HaSGO/bromoTimer/README.md

bromoTimer
==========

A timer circuit for a bromograph
