HaSGO/bromoTimer/Schematics/BromoTimer.brd

## EAGLE design Schematics/BromoTimer.brd (2014-05-28)

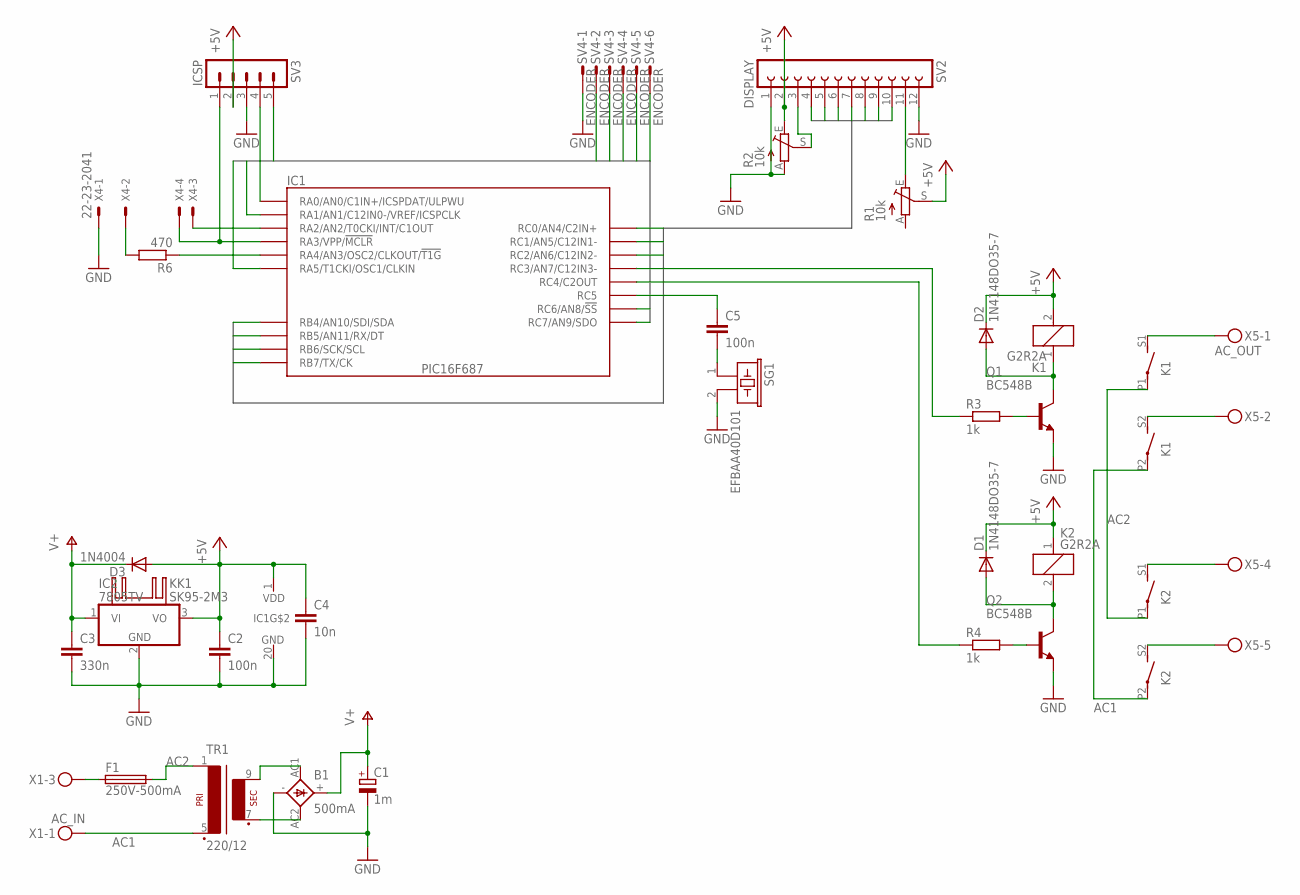
[picture p1: schematic BromoTimer.sch]

Parts:
B1: 500mA; 2KBB-R
C1: 1m; E5-13
C2: 100n; C025-024X044
C3: 330n; C050-050X075
C4: 10n; C025-024X044
C5: 100n; C075-032X103
D1, D2: 1N4148DO35-7; DO35-7
D3: 1N4004; DO41-10
F1: 250V-500mA; SH22
IC1: PIC16F687; DIP20
IC2: 7805TV; TO220V
K1, K2: G2R2A; MPN G2R-2A-DC24
KK1: SK95-2M3
Q1, Q2: BC548B; TO92-EBC
R1, R2: 10k; CA6V
R3, R4: 1k; 0207/7
R6: 470; 0207/7
SG1: EFBAA40D101
SV2: DISPLAY; FE12
SV3: ICSP; MA05-1
SV4: ENCODER; L06P
TR1: 220/12; EI30-1
X1: AC_IN; MKDSN1,5/3-5,08
X4: 22-23-2041
X5: AC_OUT; MKDSN1,5/5-5,08

Connections:
+5V: C2.1, C4.1, D1.C, D2.C, D3.A, IC1.1 (VDD), IC2.3 (VO), K1.2, K2.1, R1.S, R2.E, SV2.2, SV3.2
A: IC1.19 (RA0/AN0/C1IN+/ICSPDAT/ULPWU), SV3.4, SV4.5
AC1: K1.P2, K2.P2, TR1.5 (P2), X1.1
AC2: F1.2, K1.P1, K2.P1, TR1.1
B: IC1.18 (RA1/AN1/C12IN0-/VREF/ICSPCLK), SV3.5, SV4.6
B0: IC1.13 (RB4/AN10/SDI/SDA), SV2.7
B1: IC1.12 (RB5/AN11/RX/DT), SV2.8
B2: IC1.11 (RB6/SCK/SCL), SV2.9
B3: IC1.10 (RB7/TX/CK), SV2.10
EN: IC1.16 (RC0/AN4/C2IN+), SV2.6
GND: B1.-, C1.-, C2.2, C3.2, C4.2, IC1.20 (GND), IC2.2 (GND), Q1.E, Q2.E, R2.A, SG1.2, SV2.1, SV2.12, SV3.3, SV4.1, X4.1
LG: IC1.9 (RC7/AN9/SDO), SV4.2
LR: IC1.8 (RC6/AN8/!SS), SV4.3
unnamed: R1.E, SV2.11
unnamed: B1.AC2, TR1.7 (S3)
unnamed: R2.S, SV2.3
unnamed: Q2.B, R4.2
unnamed: Q1.B, R3.2
unnamed: D1.A, K2.2, Q2.C
unnamed: D2.A, K1.1, Q1.C
unnamed: K1.S1 (S), X5.1
unnamed: K1.S2 (S), X5.2
unnamed: K2.S1 (S), X5.4
unnamed: K2.S2 (S), X5.5
unnamed: B1.AC1, TR1.9 (S4)
unnamed: IC1.17 (RA2/AN2/T0CKI/INT/C1OUT), X4.3
unnamed: IC1.6 (RC4/C2OUT), R4.1
unnamed: IC1.4 (RA3/VPP/!MCLR), SV3.1, X4.4
unnamed: IC1.7 (RC3/AN7/C12IN3-), R3.1
unnamed: C5.1, IC1.5 (RC5)
unnamed: C5.2, SG1.1
unnamed: IC1.3 (RA4/AN3/OSC2/CLKOUT/!T1G), R6.1
unnamed: R6.2, X4.2
unnamed: F1.1, X1.3
RS: IC1.15 (RC1/AN5/C12IN1-), SV2.4
RW: IC1.14 (RC2/AN6/C12IN2-), SV2.5
SW: IC1.2 (RA5/T1CKI/OSC1/CLKIN), SV4.4
V+: B1.+, C1.+, C3.1, D3.C, IC2.1 (VI)

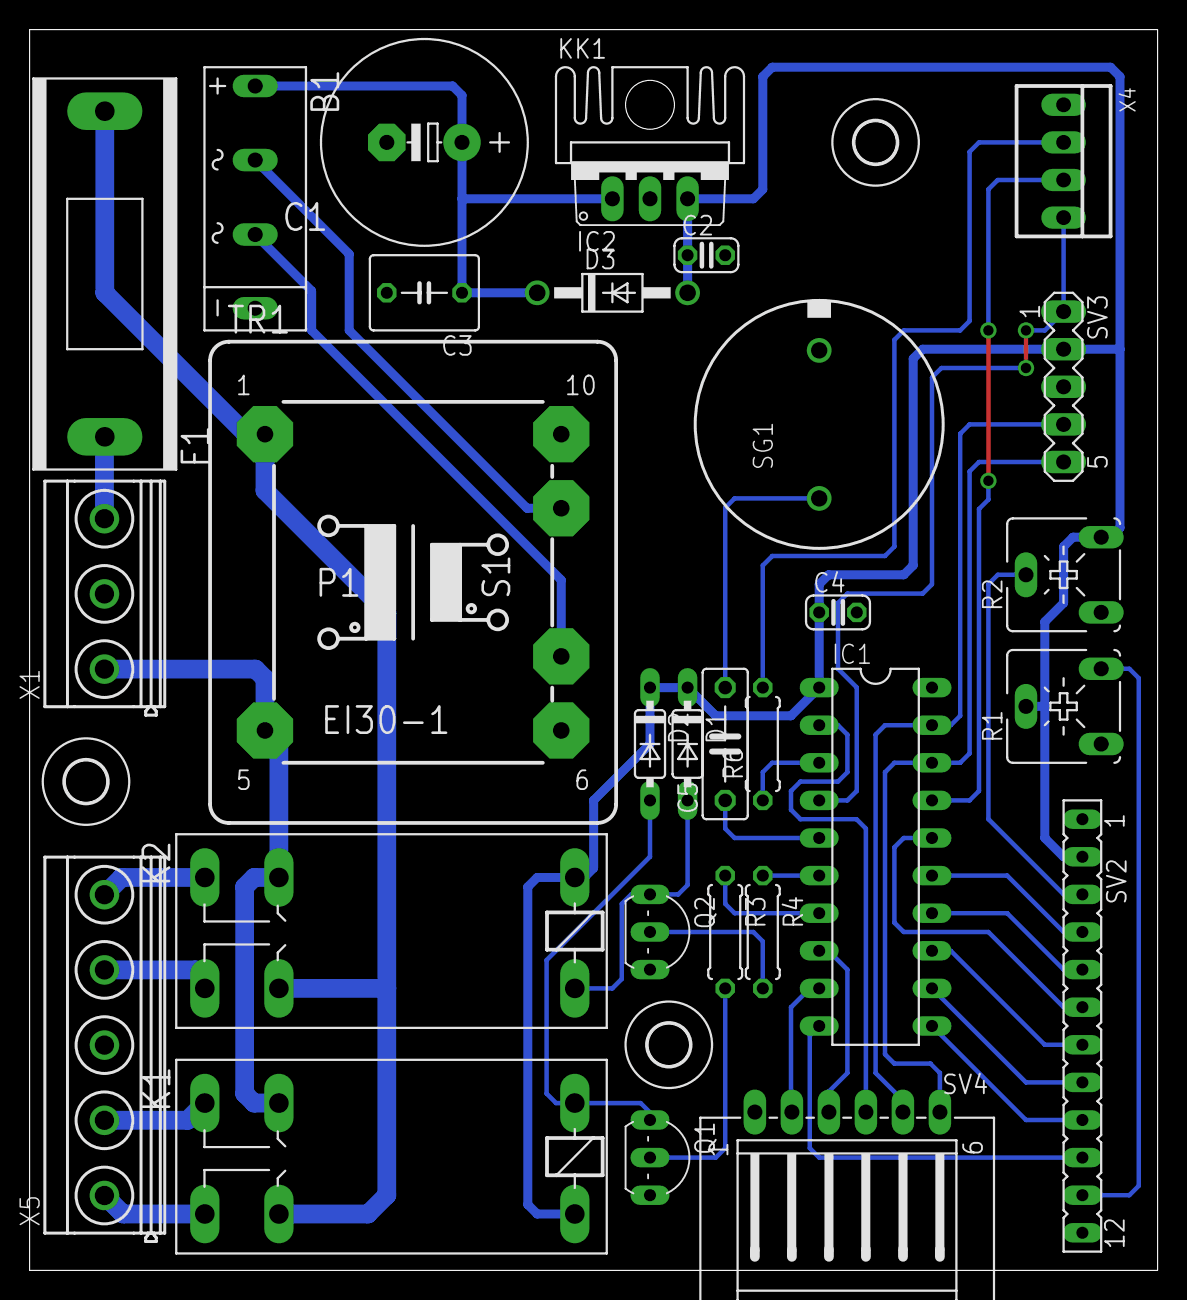
[picture p2: board BromoTimer.brd from above]

Board: 2 copper layers, 76.2 x 83.8 mm, 33 parts (0 on the bottom side), 38 nets.

Other parts of the board:
U$2, U$3, U$4: 2,8
