HaSGO/bromoTimer/Schematics/encoder.brd

## EAGLE design Schematics/encoder.brd (2013-06-17)

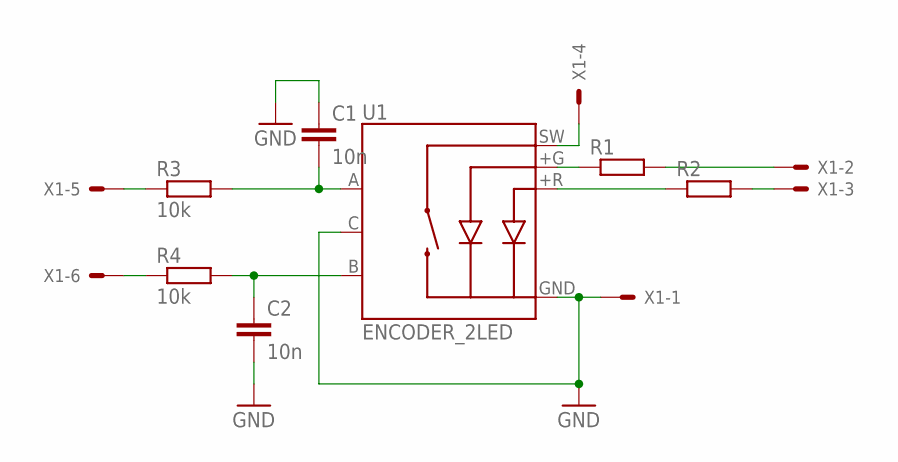
[picture p3: schematic encoder.sch]

Parts:
C1, C2: 10n; C025-024X044
R1, R2: R-EU_R0603; R0603
R3, R4: 10k; R0603
U1: ENCODER_2LED; ENCODER_LED_2
X1: 22-23-2061

Connections:
GND: C1.1, C2.2, U1.C, U1.GND (-), X1.1
unnamed: R1.2, X1.2
unnamed: R2.2, X1.3
unnamed: R1.1, U1.+G
unnamed: U1.SW, X1.4
unnamed: C1.2, R3.2, U1.A
unnamed: C2.1, R4.2, U1.B
unnamed: R2.1, U1.+R
unnamed: R4.1, X1.6
unnamed: R3.1, X1.5

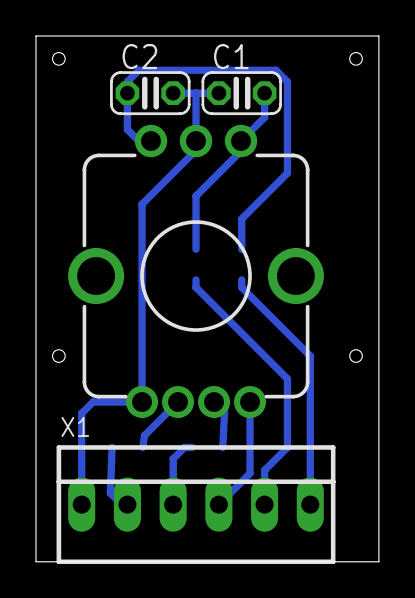
[picture p4: board encoder.brd from above]

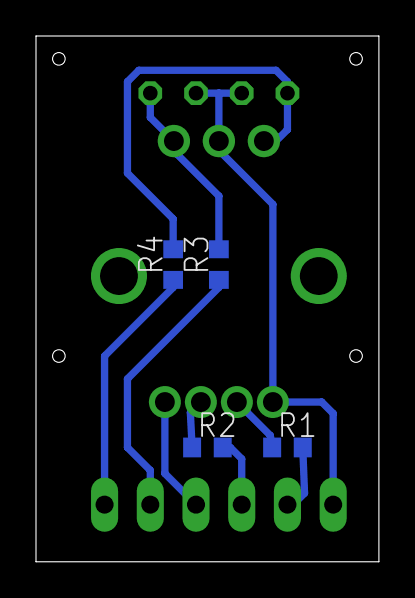
[picture p5: board encoder.brd from below]

Board: 2 copper layers, 19.1 x 29.2 mm, 8 parts (4 on the bottom side), 10 nets.
