HaSGO/bromoTimer/bromoTimer.X/main.c

/******************************************************************************/
/* Files to Include                                                           */
/******************************************************************************/

#include <xc.h>           /* Global Header File */
#include <stdint.h>        /* For uint8_t definition */
#include <stdbool.h>       /* For true/false definition */
#include <conio.h>
#include <stdio.h>

#include "system.h"        /* System funct/params, like osc/peripheral config */
#include "user.h"          /* User funct/params, such as InitApp */
#include "lcd.h"

/******************************************************************************/
/* User Global Variable Declaration                                           */
/******************************************************************************/

/* Current encoder value set by user */
uint16_t seconds = 1;

/******************************************************************************/
/* Main Program                                                               */

/******************************************************************************/

/* This function reads system flags and acts upon them. */
void inline ProcessFlags() {
    if (system_flags & ENCODER_BUTTON_PRESSED) {
        system_flags &= ~ENCODER_BUTTON_PRESSED; /* Reset encoder flag */
        if (status == mode_NOP) {
            printf("\rTurn knob to set");
            status = mode_SET;
        } else if (status == mode_SET) {
            //Start countdown
            start_countdown(seconds);
        }

    }
    if (system_flags & LID_OPEN) {
        system_flags &= ~LID_OPEN; /* Reset lid open flag */
        // User has opened lid. Check if we are counting down.
        if (status == mode_COUNTDOWN) {
            TMR1ON = 0; //Stop timer
            printf("\rLid open");
        }
    }
    if (system_flags & TIMER1_OVERFLOW) {
        system_flags &= ~TIMER1_OVERFLOW;
        /* Reset timer value */
        TMR1H = 0b10000101;
        TMR1L = 0b11101110;
        /* decrement second counter */
        if (!--seconds) { /* If we are decrementing to 0, we are done */
            LAMP_1 = 0;
            LAMP_2 = 0;
            TMR1ON = 0;
            EXT_LED = 0;
            status = mode_NOP;

            printf("\rDone!");
            PlayBuzzerMs(100);
            __delay_ms(100);
            PlayBuzzerMs(100);
        } else {
            lcd_gotoxy(2, 3); /* Go to a space after the word "remaining" */
            printf("%us", seconds);
        }
    }
}

uint8_t main(void) {
    /* Configure the oscillator for the device */
    ConfigureOscillator();

    /* Initialize I/O and Peripherals for application */
    InitApp();

    if (EXT_SW == 0) {
        printf("\rSelf test...");
        __delay_ms(200);
        SelfTest();
        printf("\r...end");
        __delay_ms(200);
        while (EXT_SW == 0) NOP();
    }

    EXT_LED = 1;

    printf("\rHaSGO Bromograph");

    static const int8_t enc_states[] = {0, -1, 1, 0, 1, 0, 0, -1, -1, 0, 0, 1, 0, 1, -1, 0};
    static uint8_t old_AB = 0;

    while (1) {
        ProcessFlags();

        switch (status) {
            case mode_SET:
                old_AB <<= 2; //remember previous state
                old_AB |= (PORTA & 0x03); //add current state
                if (enc_states[(old_AB & 0x0f)]) {
                    seconds += enc_states[(old_AB & 0x0f)];
                    lcd_clear();
                    printf("\rTimer: %us", seconds);
                }
                break;
            case mode_NOP:
                NOP();
                break;
        }
    }

    return 0;
}
