HaSGO/bromoTimer/bromoTimer.X/configuration_bits.c

/******************************************************************************/
/* Main Files to Include                                                      */
/******************************************************************************/

#include <xc.h>            /* HiTech General Includes */

/******************************************************************************/
/* Configuration Bits                                                         */
/*                                                                            */
/* Refer to your Hi-Tech User Manual in the PICC installation directory       */
/* /doc folder for more information on filling in configuration bits.         */
/* In addition, configuration bit mnemonics can be found in your              */
/* PICC\version\include\<processor name>.h file for your device.  For         */
/* additional information about what the hardware configurations mean in      */
/* terms of device operation, refer to the device datasheet.                  */
/*                                                                            */
/******************************************************************************/

// CONFIG
#pragma config FOSC = INTRCIO   // Oscillator Selection bits (INTOSCIO oscillator: I/O function on RA4/OSC2/CLKOUT pin, I/O function on RA5/OSC1/CLKIN)
#pragma config WDTE = OFF       // Watchdog Timer Enable bit (WDT disabled and can be enabled by SWDTEN bit of the WDTCON register)
#pragma config PWRTE = ON       // Power-up Timer Enable bit (PWRT enabled)
#pragma config MCLRE = OFF      // MCLR Pin Function Select bit (MCLR pin function is MCLR)
#pragma config CP = OFF         // Code Protection bit (Program memory code protection is disabled)
#pragma config CPD = OFF        // Data Code Protection bit (Data memory code protection is disabled)
#pragma config BOREN = OFF      // Brown-out Reset Selection bits (BOR disabled)
#pragma config IESO = OFF       // Internal External Switchover bit (Internal External Switchover mode is disabled)
#pragma config FCMEN = OFF      // Fail-Safe Clock Monitor Enabled bit (Fail-Safe Clock Monitor is disabled)
