HaSGO/bromoTimer/bromoTimer.X/user.h

/******************************************************************************/
/* User Level #define Macros                                                  */
/******************************************************************************/

/******************************************************************************/
/* User Function Prototypes                                                   */
/******************************************************************************/

void InitApp(void);         /* I/O and Peripheral Initialization */

inline void SelfTest();
