HaSGO/bromoTimer/(commit log)

2012-12-02 Initial commit
    Schematic is nearly done; still have to check dimensions and lay out the board.
    [BromoTimer.sch]
2012-12-02 Ignore EAGLE board backups
2012-12-02 Finished first version of the schematic.
    [BromoTimer.sch]
2012-12-02 Add board, initial component placement
    Still have to confirm component size & footprint.
    [BromoTimer.brd]
2012-12-08 Fixed bug in schematics
    The poles on the diode bridge were inverted.
    [BromoTimer.brd, BromoTimer.sch]
2012-12-08 Use 12V relay.
    Use 12V relay since V relays are not common.
    [BromoTimer.brd, BromoTimer.sch]
2012-12-08 Add ICSP header
    [BromoTimer.brd, BromoTimer.sch]
2012-12-08 Add buzzer and diode protection to 7805.
    [BromoTimer.brd, BromoTimer.sch]
2012-12-08 Add support for external LED
    [BromoTimer.brd, BromoTimer.sch]
2012-12-09 Add 1n4004 diode
    [BromoTimer.brd, BromoTimer.sch]
2012-12-09 Fix bug in relay protection
    [BromoTimer.brd, BromoTimer.sch]
2012-12-09 Add on-board buzzer
    [BromoTimer.brd, BromoTimer.sch]
2012-12-09 Fixed footprints, added resistor for main led.
    [BromoTimer.brd, BromoTimer.sch]
2012-12-09 Better connector pinouts
    [BromoTimer.brd, BromoTimer.sch]
2012-12-12 Add proper footprint for relays
    [BromoTimer.brd, BromoTimer.sch]
2012-12-12 Initial component layout.
    [BromoTimer.brd, BromoTimer.sch]
2012-12-12 Fix some ERC errors
    Come traces were not connected on the transformer, R1 and R2 were missing
    values, so was TR1.
    [BromoTimer.brd, BromoTimer.sch]
2012-12-12 Eye candy changes
    Added a frame for the power circuits, moved the components around to better
    fit the frame.
    [BromoTimer.sch]
2012-12-12 Component placement finished
    This is just a candidate though. The area with Q1 Q2 and Q3 could get optimized
    a little more though...
    [BromoTimer.brd, BromoTimer.sch]
2012-12-12 Adjusted some positions in the board layout
    [BromoTimer.brd, BromoTimer.sch]
2012-12-12 Relay coil voltage is 5V
    [BromoTimer.sch]
2012-12-12 Routing nearly done
    [BromoTimer.brd, BromoTimer.sch]
2012-12-12 Integrating a fuse in the circuit
    Moved the supply circuit a bit to make room for the fuse holder.
    [BromoTimer.brd, BromoTimer.sch]
2012-12-12 Routing complete
    Well, nearly... I routed everything but two wires.
    [BromoTimer.brd]
2012-12-23 Routing completed, no jumper wires
    Routing fully completed, RDC passing.
    [BromoTimer.brd, BromoTimer.sch]
2013-01-11 migrate to EAGLE 6.4.0
    [BromoTimer.brd, BromoTimer.sch]
2013-01-13 Add support for lid state sensor
    [BromoTimer.brd, BromoTimer.sch]
2013-01-19 Small changes to PCB layout.
    [BromoTimer.brd, BromoTimer.sch]
2013-01-20 Add board name & version in layout.
    [BromoTimer.brd]
2013-01-20 moved R2, R4, R5 and Q3 to better positions.
    [BromoTimer.brd]
2013-02-10 Define pin functions.
    Define all pin functions based on circuit.
2013-02-16 Swap functionality of RA3 and RA4
    Internal pullup not available on RA3, but needed for lid sensor.
    [user.h]
2013-03-09 Add encoder PCB
    Added the encoder mini PCB, schematics with the correct footprint.
    [encoder.brd, encoder.sch]
2013-03-09 Clean up R1
    [BromoTimer.brd, BromoTimer.sch]
2013-03-09 Implement sample code
    When programmed, this should toggle the buzzer on and off.
    [main.c, system.h]
2013-03-10 Correct trimmer footprints
    [BromoTimer.brd, BromoTimer.sch]
2013-03-10 Add caps to encoder breakout
    [encoder.brd, encoder.sch]
2013-03-10 Increase default keepout
    Default keepout increased to 25mil. Also, inverted function of RC6 and RC7.
    Change is also made in code to reflect this.
    [BromoTimer.brd, BromoTimer.sch]
2013-03-18 Configure internal RC oscillator
    [system.c]
2013-03-24 Disable relay and buzzer at boot.
    [user.c]
2013-03-24 Enable pull-ups on A & B encoder lines
2013-03-24 Encoder test mode
2013-03-25 New PCB prototype
    The new PCB is a little taller and a lot less wide. It has extra space for the
    7805 heatsink. Connector layout should be better, too.
    [BromoTimer.brd, BromoTimer.sch]
2013-03-25 Final touches
    Mitered the last corners, optimized some tracks, minor changes.
    [BromoTimer.brd]
2013-04-03 Custom PIC part, minor layout changes
    Schematic:
    - changed encoder connector to right angle type
    - rewired trimmer for LCD contrast, it needs to vary voltage, not resistance
    - add net class for power line, specifying 24thou width and 12thou keepout
    - LCD trimmers are 10k, not 100k
    - add decoupling cap to IC1
    - rename bus lines to LR and LG instead of L1 and L2
    Board:
    - moved power components on a slightly better place
    - aligned diodes and resistors
    [BromoTimer.brd, BromoTimer.sch]
2013-04-03 Add current limiting resistors for LEDs
    [encoder.brd, encoder.sch]
2013-04-04 Swap RA3 and RA4 function.
    This was an error, RA3 is input only! So, external led is controlled via RA4
    (there's a current limiting resistor attached to it in the schematics, too) and
    RA3 is the lid sensor input.
    [user.h]
2013-04-06 Use piezo instead of buzzer, add mounting holes
    Use piezo instead of a buzzer so we save a resistor and a transistor. The piezo
    will ring via PWM by the PIC. Re-routed portions of the PCB for a better fit.
    Add mounting holes to PCB.
    [BromoTimer.brd, BromoTimer.sch]
2013-05-26 Add LCD library.
    Amended to correct some bugs, mainly with an extra enable when sending a byte in
    nibble mode.
    [lcd.c, lcd.h]
2013-05-26 Moved pin specifications
    It makes much more sense to store pin specifications in system.h.
2013-05-26 Add routine to play buzzer
    Buzzer type was changed from electromechanical beeper to piezoelectric. For it
    to work, we have to excite it with a 4 kHz square wave.
    [main.c, system.c, system.h]
2013-05-26 Fix small TRISA bug
    RA4 is the only output, not RA3. Also, disable weak pull-up on RA3 since WPU is
    not supported on that pin.
    [user.c]
2013-05-26 Add putch() routine
    This enables the use of the printf() function in the standard library.
    Also, initialize the LCD display on application init.
2013-05-26 Disable all LEDs at initialization.
2013-05-26 Add self-test routine
    The self-test routine lights every available LED and clicks both relays to test
    everything.
2013-05-26 Read from encoder
    Enable interrupt-on-change on RA0 and RA1 to read from encoder. Encoder turns
    modify a global counter, which is displayed on the LCD in the main loop.
2013-06-08 Implementing basic state system
    Just a basic state machine, switches from getting a value and displaying "Menu".
2013-06-17 Enhance selftest mode
    This patch adds a while loop to wait for the user to depress the encoder switch
    before exiting selftest mode and continuing with the program.
2013-06-17 Refactor enc_val to seconds
    This variable will be used to specify the timer seconds. Also, using the
    correct mask for printf.
    [main.c]
2013-06-17 Implement basic flag system
    Flags are set according to interrupts to process events synchronously in the
    main loop. This is to keep the ISR short and simple, and to limit the number
    of global variables.
    This patch implements a basic timer system, first the user selects the time and
    on a button press the microcontroller activates both lamps and starts counting
    down. When the timer ends, both lamps are shut down and the system can start
    again.
    Timer is set up using the timer1 peripheral, a 16 bit timer. Counting from a
    fixed number up in order to create an interrupt every second. Drift is minimal
    ( approx 0.5s every 60 seconds) and could be improved in the future.
    [interrupts.c, main.c, system.h, user.c]
2013-06-17 bromotimer PCB: added low pass filter to encoder
    Added LPF to avoid chattering, added holes to encoder pcb.
    [encoder.brd, encoder.sch]
2013-06-17 Fix some DRC errors
    [BromoTimer.brd]
2013-07-14 BromoTimer board: aligned pots
    Both potentiometers are aligned now. Also, manually approved DRC clearance
    errors between 220V terminal pins.
    [BromoTimer.brd]
2013-07-15 Enhanced UI a bit
    Added frendlier messages, and do not rewrite whole line in countdown mode, but
    just the seconds. This still has some bugs, namely, then the seconds go from
    hundreds to tens and from tens to ones the trailing digit is not erased.
    [main.c]
2014-05-22 Use more meaningful character to reset LCD character counter
    [main.c, system.c]
2014-05-22 Enable lid sensing
    This commit enables the timer to stop when lid is opened.
2014-05-28 Fix lid bug
    MCLR is connected to the lid sensor, so it can't be used.
    [configuration_bits.c]
2014-05-28 Remember to reset flags
    [main.c]
2014-05-28 Use external switch for self test
2014-05-28 Enable pull-up on RA3 pin
    This should definitively fix the lid sensor malfunctioning
    [user.c]
2014-05-28 Light up LED only when we finish self test.
    Also, fix small bug.
    [main.c]
2014-05-28 Remove bogus attribute
    [BromoTimer.brd]
2014-05-28 Use \n in printf to move to the second half of the LCD
2014-05-28 Update project to EAGLE 6.5
    [BromoTimer.brd]
